AitenAndGo/SpacePayloadDesign/Sketches/566396279_1453702169041624_7734353768795741561_n.jpg

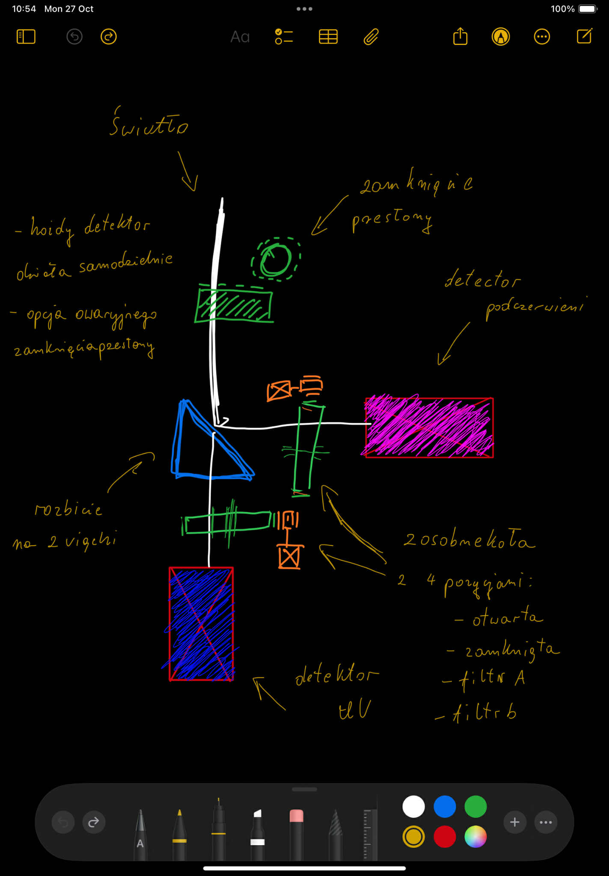
Sketches/566396279_1453702169041624_7734353768795741561_n.jpg
