AitenAndGo/SpacePayloadDesign/Sketches/566613046_1358015939291041_1034817544731382815_n.jpg

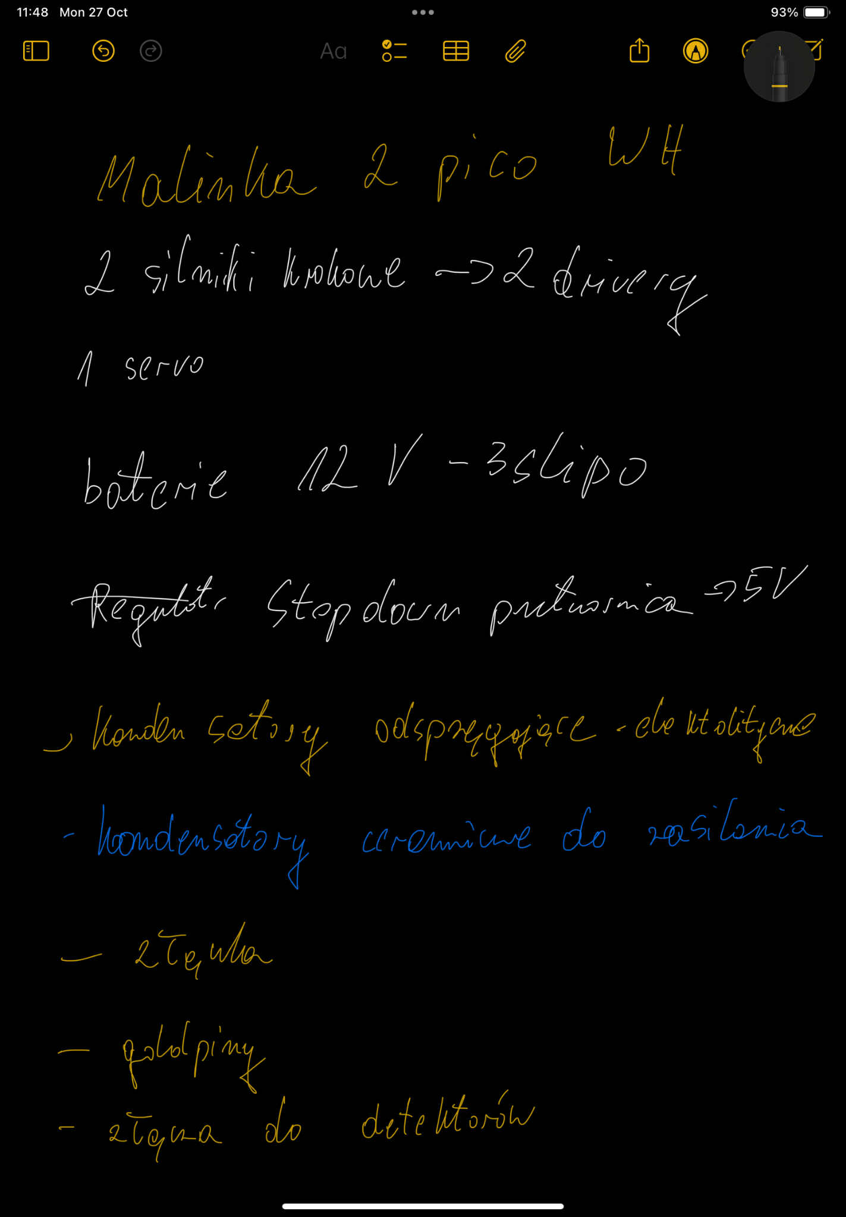
Sketches/566613046_1358015939291041_1034817544731382815_n.jpg
