AitenAndGo/SpacePayloadDesign/Docs/SPD-AGH-CL-001_i1.0_WIDMO_COMPONENT LIST.xlsx

Category | Item Name | Parameters / Technical Details | Qty | Store Link (Paste here) | Price [PLN]
1. DRIVE (MAXON) | Motor: ECX SPEED 16 L | 24V, BLDC, 3-phase control. Integrated with GPX gearhead and encoder. | 1 | https://www.maxongroup.pt/maxon/view/product/motor/Konfigurierbare-Motoren/Buerstenlose-DC-Motoren/ECX16-SPEED/ECXZ16L1KN46K1SC1D399A
1. DRIVE (MAXON) | Gearhead: GPX 19 A | Ratio 590:1. Planetary version. | 1 | https://www.maxongroup.pt/maxon/view/product/gear/planetary/GPX/GPX19/GPX19-4-Stufig-A/GPX19AAKLSL0590CPLW
1. DRIVE (MAXON) | Encoder: ENX 16 EASY | Incremental, integrated version. | 1 | https://www.maxongroup.com/maxon/view/product/sensor/encoder/Magnetische-Encoder/ENX16EASY-INT/ENX16EASYINT01
1. DRIVE (MAXON) | Driver: EPOS4 Compact 50/8 CAN | "Boxed" version (Compact). Supply 10-50V. CANopen interface. (P/N: 520885). | 1 | https://www.maxongroup.com/maxon/view/product/control/Positionierung/EPOS-4/520885
2. PCB - LOGIC | Raspberry Pi Pico 2 W | Microcontroller with WiFi/BLE. For surface mount (SMD) or header soldering. 3.3V Logic. | 1 | https://botland.com.pl/moduly-i-zestawy-do-raspberry-pi-pico-2/26286-raspberry-pi-pico-2-wh-rp2350-arm-cortex-m33-cyw43439-wifibluetooth-ze-zlaczami.html | 31.12
3. PCB - CAN | CAN Controller: MCP2515 | Package: TSSOP-20 (smaller) or SOIC-18. SPI Interface. | 1 | https://www.tme.eu/pl/details/mcp2515-i_so/uklady-scalone-interfejs-can/microchip-technology/ | 8.9
3. PCB - CAN | CAN Transceiver: SN65HVD230 | Critical: Must be the 3.3V version (do NOT use TJA1050). Package: SOIC-8. | 1 | https://www.tme.eu/pl/details/sn65hvd230dr/uklady-scalone-interfejs-can/texas-instruments/ | 8.43
3. PCB - CAN | Crystal Oscillator: 16 MHz | Or 16 MHz. Required for MCP2515 clocking. | 1 | https://botland.com.pl/rezonatory/166-rezonator-kwarcowy-16mhz-hc49-niski-10szt-5904422358761.html | 5.9
3. PCB - CAN | Crystal Capacitors | 22pF (Ceramic, SMD 0603/0805). For the oscillator circuit. | 2 | https://botland.com.pl/kondensatory-ceramiczne-tht/448-kondensator-ceramiczny-22pf-50v-tht-10-szt-5904422355609.html | 0.99
3. PCB - CAN | Termination Resistor | 120 Ω (Ohm), SMD 0805/1206. Place between CAN H and CAN L lines. | 1 | https://www.tme.eu/pl/details/cf1_4w-120r/rezystory-tht/sr-passives/ | 3.08
4. PCB - SENSORS | UV Photodiode: | Czujnik światła ultrafioletowego UV - analogowy moduł - Waveshare 9537 | 1 | https://botland.com.pl/czujniki-swiatla-i-koloru/4934-czujnik-swiatla-ultrafioletowego-uv-analogowy-modul-waveshare-9537-5904422367022.html | 35.9
4. PCB - SENSORS | IR Photodiode | Czujnik płomieni 760-1100nm - Iduino SE060 | 1 | https://botland.com.pl/czujniki-swiatla-i-koloru/14255-czujnik-plomieni-760-1100nm-iduino-se060-5903351242271.html | 6.9
5. PCB - POWER | Buck Converter (Step-Down) | IC like MP1584 or ready-to-solder module (e.g., Pololu D24V5F5). Input 24V -> Output 5V. | 1 | https://botland.com.pl/przetwornice-step-down/3110-d24v5f5-przetwornica-step-down-5v-05a-pololu-2843-5904422373580.html | 32.9
5. PCB - POWER | Input Capacitor | 100uF / 35V (Electrolytic, Low ESR). For the 24V input line. | 1 | https://botland.com.pl/kondensatory-elektrolityczne-tht/898-kondensator-elektrolityczny-100uf-35v-6x12mm-105c-tht-10szt-5903351248235.html | 1.5
5. PCB - POWER | Decoupling Capacitors | 100nF (Ceramic 0603/0805). Place one near every IC (Pico, CAN, OpAmp). | ~10 | https://botland.com.pl/kondensatory-ceramiczne-tht/210-kondensator-ceramiczny-100nf50v-tht-10szt-5903351248198.html | 0.99
6. CONN | EPOS4 Connector Set | Accesories | 1 | https://www.maxongroup.com/maxon/view/product/accessory/1-mmckabel/520859 | €29.58
7. CONN (PCB SIDE) | Main Power Connector | E.g., XT30 or Screw Terminal 5.08mm. Input from Lab Power Supply. | 1 | https://botland.com.pl/zlacza-ark/13564-zlacze-ark-raster-50mm-2-pin-10szt-5904422320928.html | 4.9
8. OPTICS | Red Hot Mirror | IR cut-off filter (protects the UV/VIS sensor from heat). | 1 | https://www.thorlabs.com/thorproduct.cfm?partnumber=FM02 | €51.41
9. WIRES | Zestaw przewodów drucianych 22AWG - różne kolory - 5szt. - justPi |  | 1 | https://botland.com.pl/przewody-jednozylowe/21082-zestaw-przewodow-drucianych-22awg-rozne-kolory-5szt-justpi-5904422372743.html | 64.9
