AitenAndGo/SpacePayloadDesign/3D_printing/Parts/Drive_base.step

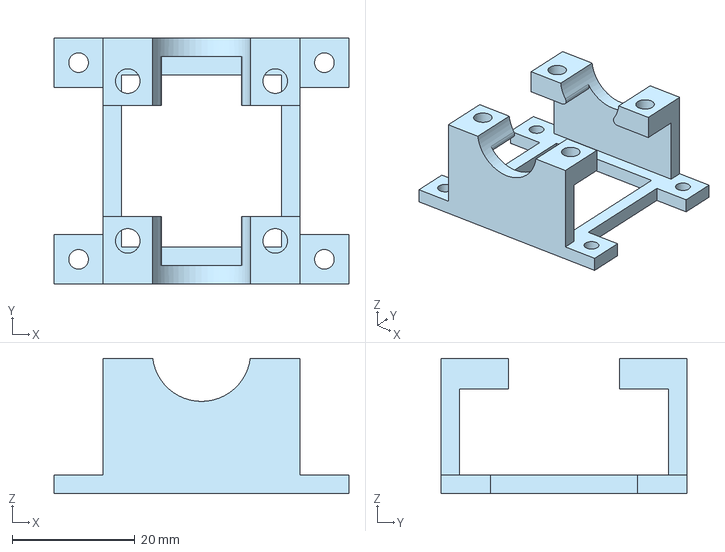
[picture p7: CAD file, 2026-01-18]
3D_printing/Parts/Drive_base.step
48.0 x 40.0 x 22.0 mm
