AitenAndGo/SpacePayloadDesign/3D_printing/Base plate cover/Base_plate_cover.step

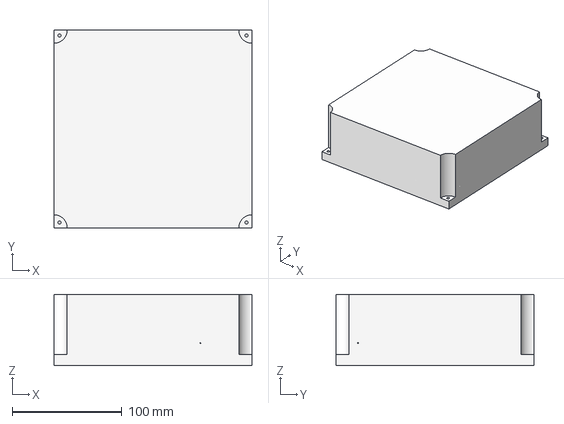
[picture p8: CAD file, 2026-01-18]
3D_printing/Base plate cover/Base_plate_cover.step
180.0 x 180.0 x 65.0 mm
