AitenAndGo/SpacePayloadDesign/3D_printing/Base plate/Base_plate.step

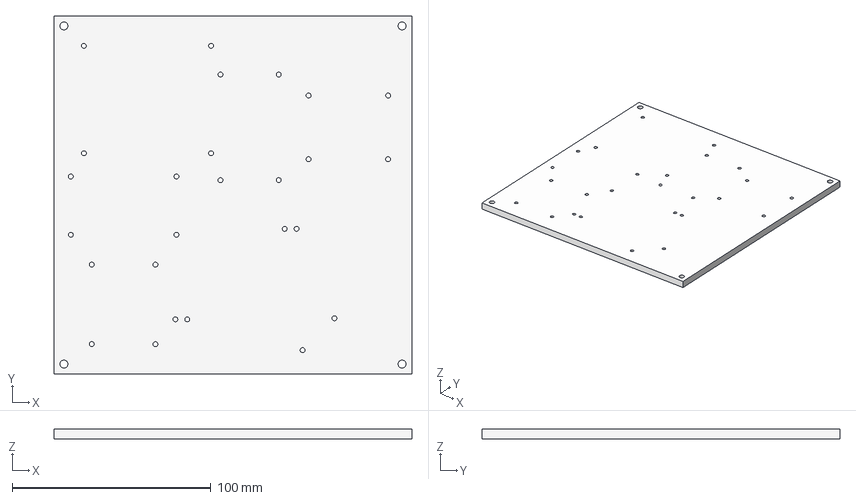
[picture p9: CAD file, 2026-01-18]
3D_printing/Base plate/Base_plate.step
180.0 x 180.0 x 5.00 mm
