AitenAndGo/SpacePayloadDesign/3D_printing/Parts/Drive_clamp.step

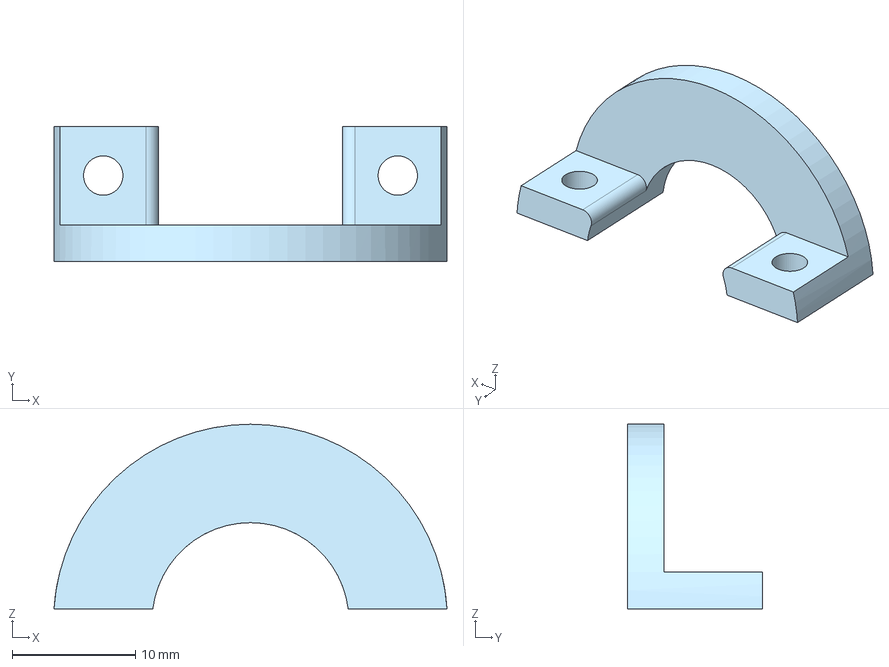
[picture p10: CAD file, 2026-01-18]
3D_printing/Parts/Drive_clamp.step
31.9 x 11.0 x 15.0 mm
