AitenAndGo/SpacePayloadDesign/3D_printing/Parts/IR_sensor_mounting.step

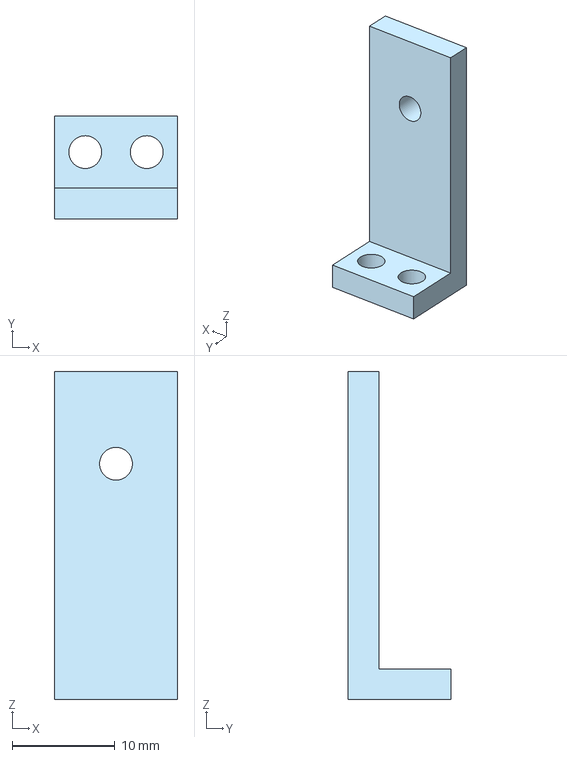
[picture p11: CAD file, 2026-01-18]
3D_printing/Parts/IR_sensor_mounting.step
12.0 x 10.0 x 32.0 mm
