AitenAndGo/SpacePayloadDesign/3D_printing/Parts/Mirror_holder.step

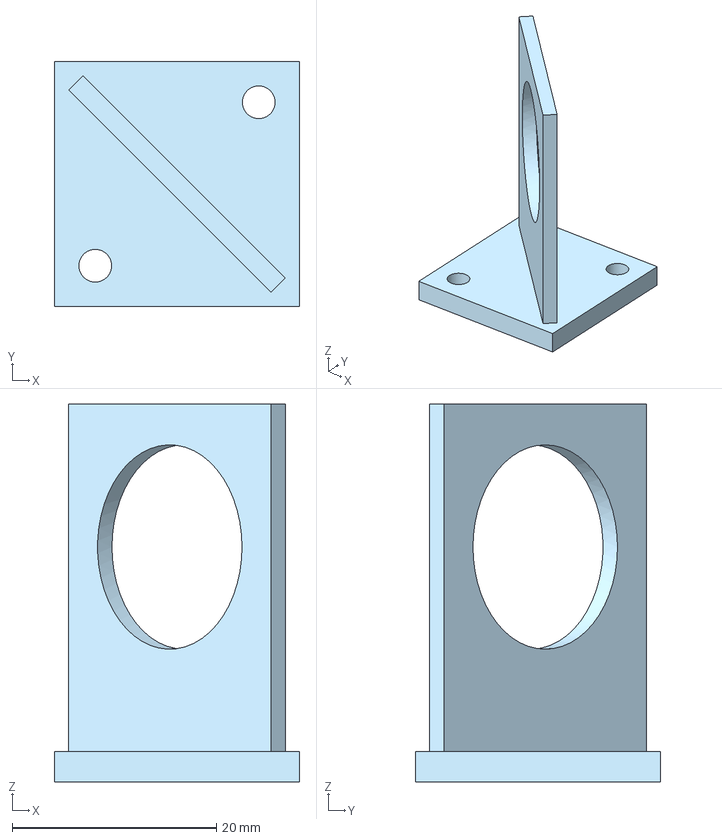
[picture p12: CAD file, 2026-01-18]
3D_printing/Parts/Mirror_holder.step
24.0 x 24.0 x 37.0 mm
