AitenAndGo/SpacePayloadDesign/3D_printing/Parts/Parts.3mf

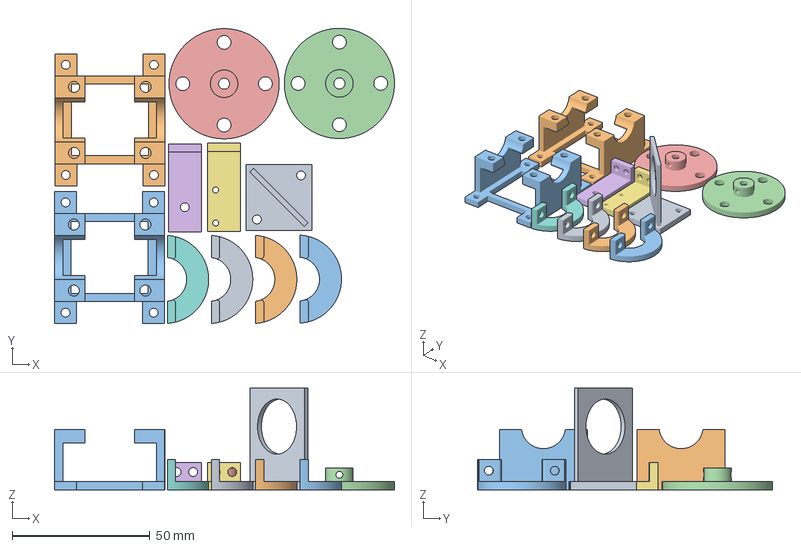
[picture p13: CAD file, 2026-01-18]
3D_printing/Parts/Parts.3mf
123.4 x 107.2 x 37.0 mm
Mirror_holder.step
Drive_base.step x 2
Filter_wheel.step x 2
IR_sensor_mounting.step
UV_sensor_mounting.step
Drive_clamp.step x 4
