AitenAndGo/SpacePayloadDesign/3D_printing/Parts/Filter_wheel.step

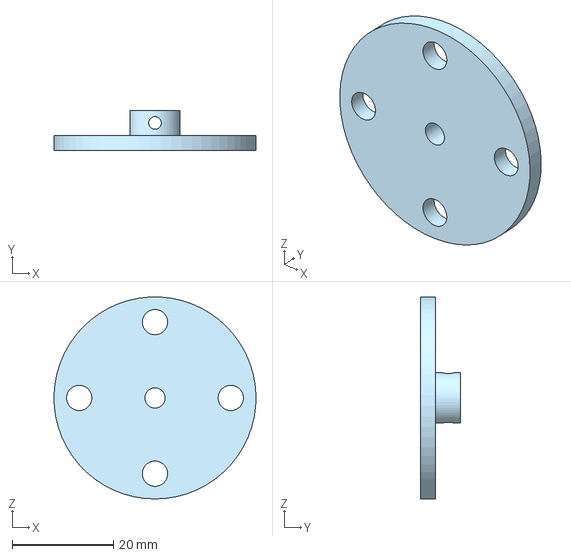
[picture p14: CAD file, 2026-01-18]
3D_printing/Parts/Filter_wheel.step
40.0 x 8.00 x 40.0 mm
