AitenAndGo/SpacePayloadDesign/(list of files, cad)

Other CAD files:
3D_printing/Base plate cover/Base_plate_cover.gcode.3mf
3D_printing/Base plate/Base_plate.gcode.3mf
3D_printing/Parts/Parts.gcode.3mf
3D_printing/Parts/UV_sensor_mounting.step
3D_printing/Base plate cover/Base_plate_cover.3mf
3D_printing/Base plate/Base_plate.3mf
