AitenAndGo/SpacePayloadDesign/Docs/SPD-AGH-ICD-002_i2.1_WIDMO_MICD.pdf

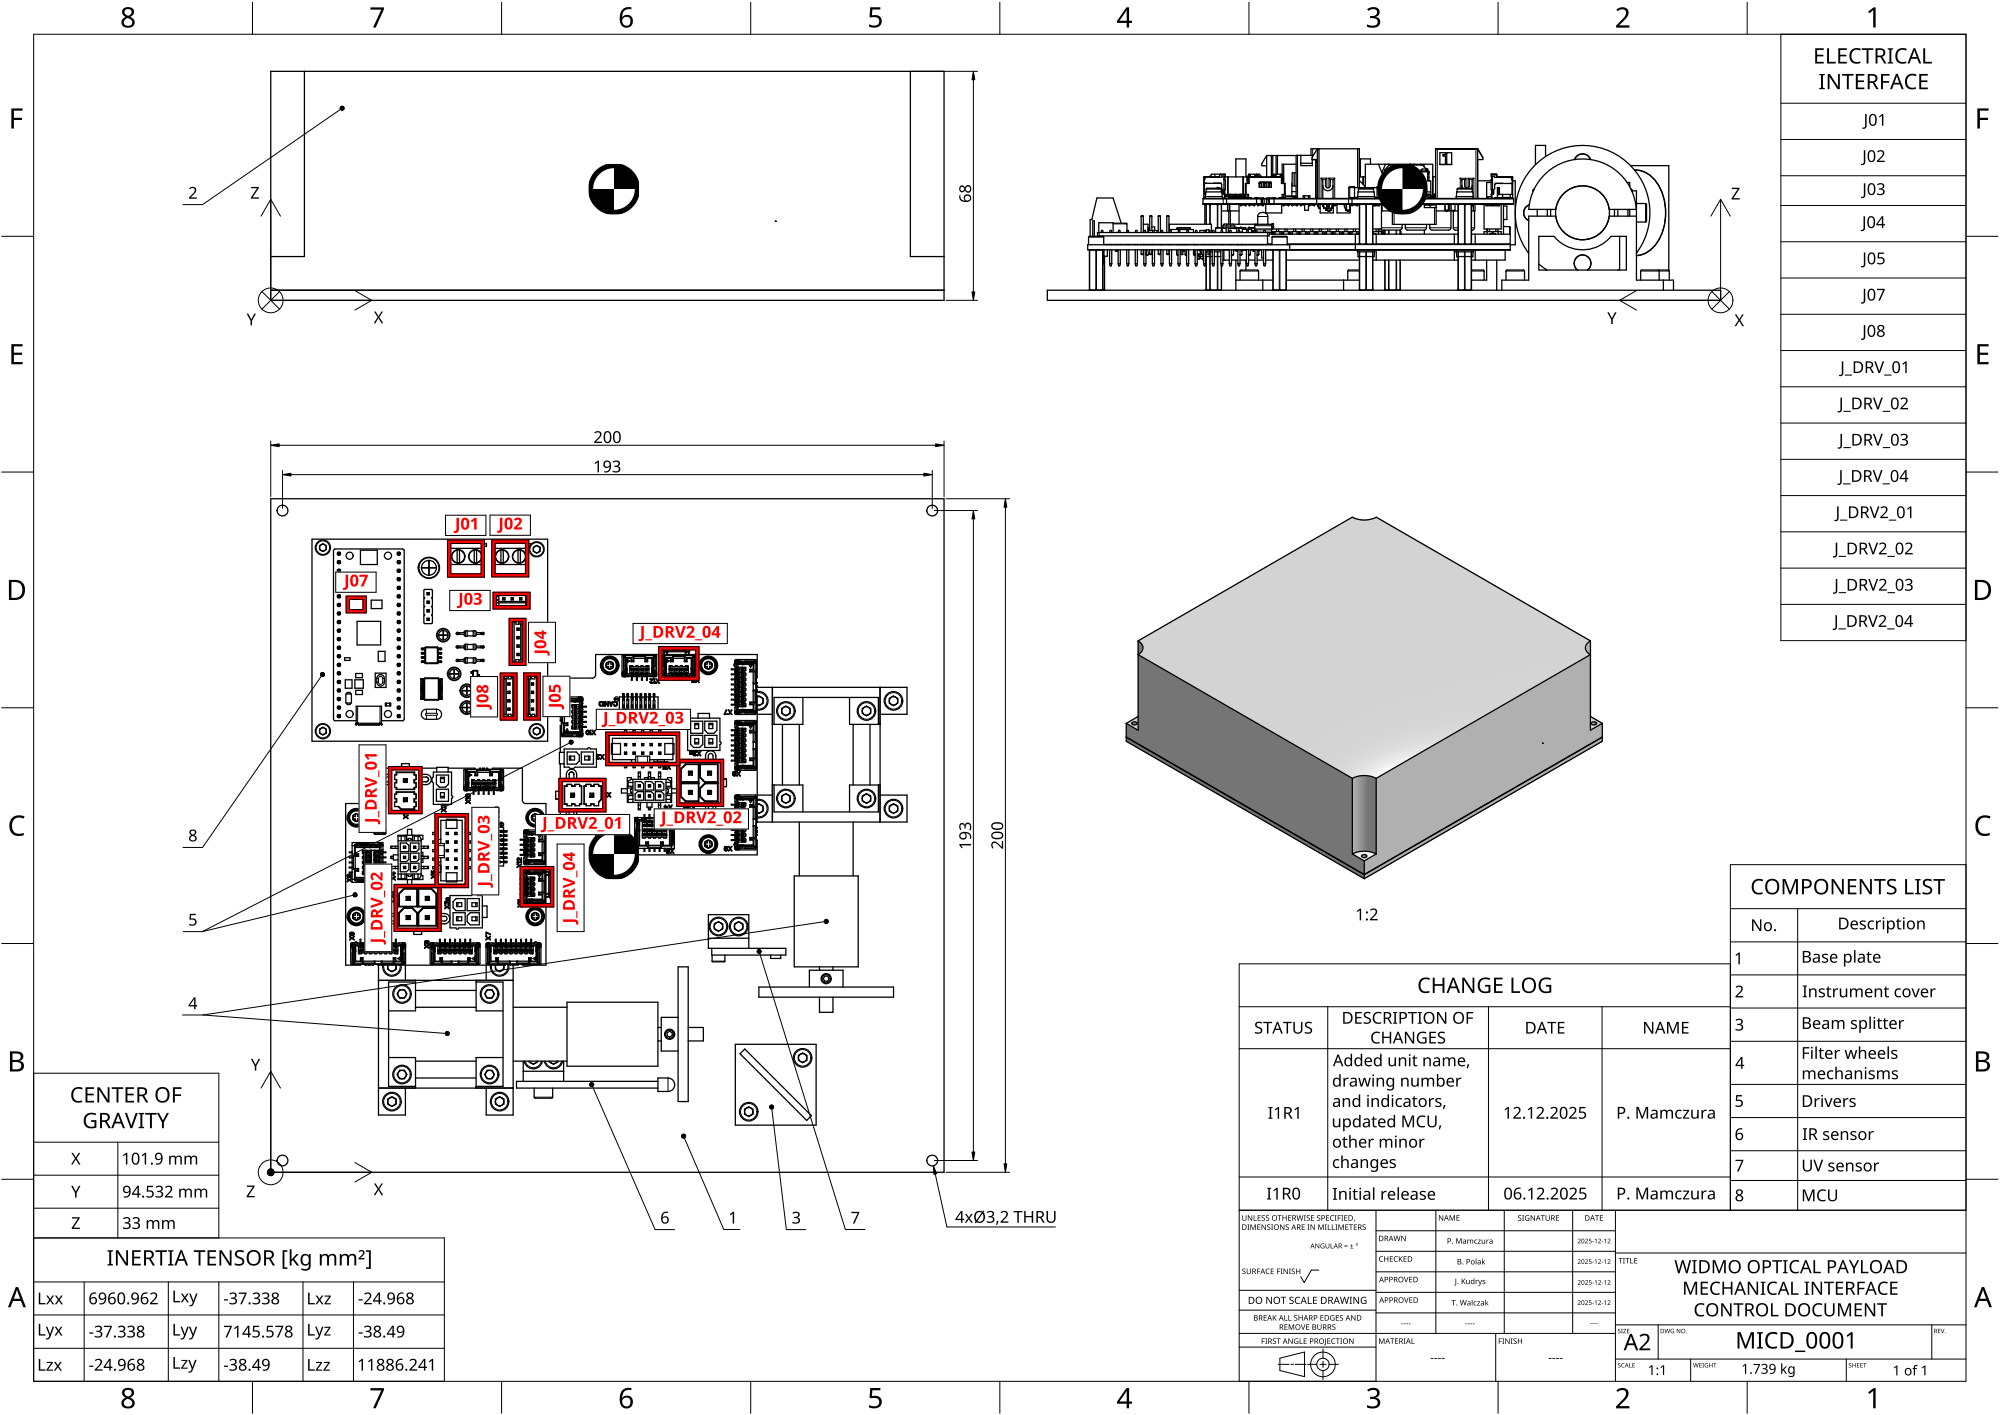
[picture p15: page 1]
