AitenAndGo/SpacePayloadDesign/(commit log)

2025-12-12 Initial documentation of the project
    [SPD-AGH-CL-001_i1.0_WIDMO_COMPONENT LIST.xlsx]
2026-01-18 Added .step and .3mf files for 3D printing
    [Base_plate.3mf, Base_plate.gcode.3mf, Base_plate.step, Base_plate_cover.3mf, Base_plate_cover.gcode.3mf, Base_plate_cover.step, Drive_base.step, Drive_clamp.step]
2026-02-06 Added simple CLI app to connect with Raspberry AP
2026-02-09 Updated mcu and cli software so it is possible to manipulate engine rotation wirelessly
2026-02-09 Minor fixed to build
    [main.c, tcp_server.c]
2026-02-09 Updated mcu software with another command and sensors readout
2026-02-09 Updated cli software with another command and sensors readout
2026-02-10 update calibration
